MCMarcusAntony/MSXPi2/hardware/Schematic/MSXPi2 - Proto1/MSXPI2.kicad_pcb

## KiCad design hardware/Schematic/MSXPi2 - Proto1/MSXPI2.kicad_pcb (2020-07-24)

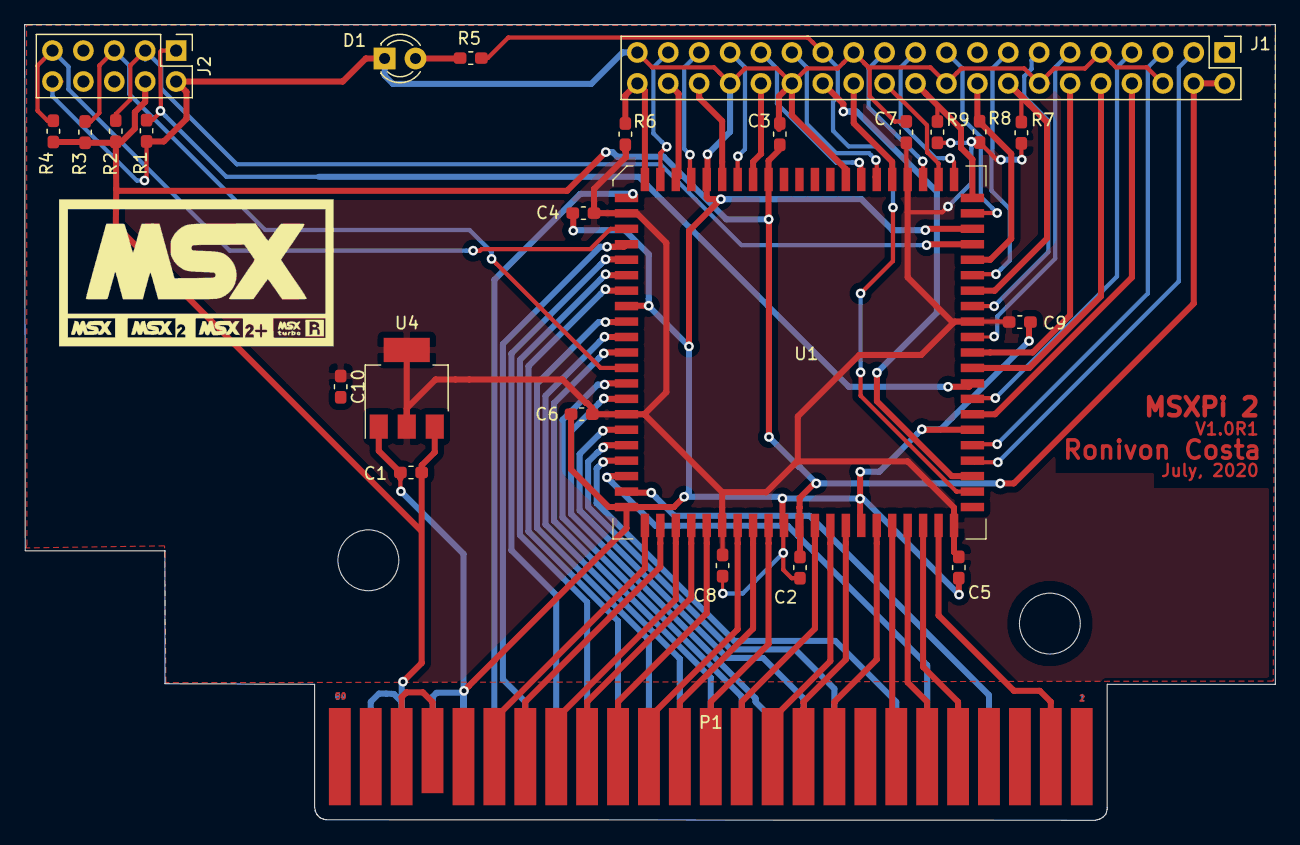
[picture p1: board MSXPI2.kicad_pcb from above]

Board: 2 copper layers, 102.8 x 65.4 mm, 25 parts (0 on the bottom side), 68 nets.

Parts:
C1, C2, C3, C4, C5, C6, C7, C8, C9, C10: C1; C_0603_1608Metric_Pad1.05x0.95mm_HandSolder
D1: LED; LED_D3.0mm
J1: Raspberry_Pi_2_3; PinHeader_2x20_P2.54mm_Vertical
J2: JTAG; PinHeader_2x05_P2.54mm_Vertical
P1: MSX_CONNECTOR; card_edge_connector
R1, R2, R3, R4, R5, R6, R7, R8, R9: R_US; R_0603_1608Metric_Pad1.05x0.95mm_HandSolder
U1: EPM7128SLC84-15; PLCC-84
U4: LD1117S33TR_SOT223; SOT-223-3_TabPin2

Connections:
+3V3: C4.2, C5.2, C6.2, C7.2, C8.2, C9.2, C10.1, R6.1, R7.1, R8.1, R9.1, U1.13, U1.26, U1.38, U1.53, U1.66, U1.78, U4.2
+5V: C1.1, C2.2, C3.2, J1.2, J1.4, J2.4, P1.45, P1.47, R2.2, R3.2, R4.2, U1.3, U1.43, U4.3
/A0: P1.28, U1.40
/A1: P1.27, U1.21
/A2: P1.30, U1.39
/A3: P1.29, U1.20
/A4: P1.32, U1.37
/A5: P1.31, U1.18
/A6: P1.22, U1.45
/A7: P1.21, U1.25
/A8: P1.24, U1.44
/A9: P1.17, U1.28
/A10: P1.20, U1.46
/A11: P1.19, U1.27
/A12: P1.23, U1.24
/A13: P1.26, U1.41
/A14: P1.25, U1.22
/A15: P1.18, U1.48
/BDIR: P1.10, U1.51
/D0: P1.34, U1.36
/D1: P1.33, U1.17
/D2: P1.36, U1.35
/D3: P1.35, U1.16
/D4: P1.38, U1.34
/D5: P1.37, U1.15
/D6: P1.40, U1.33
/D7: P1.39, U1.12
/IORQ: P1.11, U1.30
/MREQ: P1.12, U1.50
/RD: P1.14, U1.49
/SLTSL: P1.4, U1.52
/WAIT: P1.7, U1.31
/WR: P1.13, U1.29
GNDREF: C1.2, C2.1, C3.1, C4.1, C5.1, C6.1, C7.1, C8.1, C9.1, C10.2, D1.1, J1.6, J1.9, J1.14, J1.20, J1.25, J1.30, J1.34, J1.39, J2.2, J2.10, P1.41, P1.43, R1.1, U1.7, U1.19, U1.32, U1.42, U1.47, U1.59, U1.72, U1.82, U4.1
GPIO0: J1.27, R5.2, U1.55
GPIO1: J1.28, U1.56
GPIO02: J1.3, U1.57
GPIO03: J1.5, U1.58
GPIO04: J1.7, U1.61
GPIO05: J1.29, U1.80
GPIO06: J1.31, U1.81
GPIO07: J1.26, U1.79
GPIO08: J1.24, U1.76
GPIO09: J1.21, U1.75
GPIO10: J1.19, U1.73
GPIO11: J1.23, U1.77
GPIO12: J1.32, U1.4
GPIO13: J1.33, U1.5
GPIO14: J1.8, U1.60
GPIO15: J1.10, U1.63
GPIO16: J1.36, U1.6
GPIO17: J1.11, U1.65
GPIO18: J1.12, U1.64
GPIO19: J1.35, U1.8
GPIO20: J1.38, U1.9
GPIO21: J1.40, R6.2, U1.11
GPIO22: J1.15, U1.69
GPIO23: J1.16, R7.2, U1.68
GPIO24: J1.18, R8.2, U1.70
GPIO25: J1.22, R9.2, U1.74
GPIO26: J1.37, U1.10
GPIO27: J1.13, U1.67
unnamed: D1.2, R5.1
unnamed: P1.44, P1.46
TCK: J2.1, R1.2, U1.62
TDI: J2.9, R4.1, U1.14
TDO: J2.3, R2.1, U1.71
TMS: J2.5, R3.1, U1.23
