MCMarcusAntony/MSXPi2/hardware/CPLD Project/MSXPi2_Interface_Test_description.txt

Created on:Friday, July 03, 2020
Based on:MSXPi2
