MCMarcusAntony/MSXPi2/software/server/msxpi-server.py

import RPi.GPIO as GPIO
import mmap
import os
import time

version = "0.1"
build   = "20200704.00000"

# Pin Definitons
d0 = 26
d1 = 27
d2 = 2
d3 = 3
d4 = 4
d5 = 5
d6 = 6
d7 = 7

a0 = 8
a1 = 9
a2 = 10
a3 = 11
a4 = 12
a5 = 13
a6 = 14
a7 = 15
a8 = 16
a9 = 17
a10 = 18
a11 = 19
a12 = 20
a13 = 22

cs = 21
wr = 23
io = 24
rdy = 25
rpi_on = 30 # GPIO0 / ID_SD : These two pins are reserved, but may be posible
res2 = 31 # GPIO1 / ID?SC : to use them for output only - to be tested.

def init_gpio():
# Pin Setup:
    GPIO.setmode(GPIO.BCM)
    GPIO.setup(cs, GPIO.IN, pull_up_down=GPIO.PUD_DOWN)
    GPIO.setup(rdy, GPIO.OUT)
    GPIO.setup(wr, GPIO.IN)
    GPIO.setup(io, GPIO.IN)
    GPIO.setup(rpi_on, GPIO.OUT)
    GPIO.setup(res2, GPIO.OUT)
    GPIO.setup(d0, GPIO.IN)
    GPIO.setup(d1, GPIO.IN)
    GPIO.setup(d2, GPIO.IN)
    GPIO.setup(d3, GPIO.IN)
    GPIO.setup(d4, GPIO.IN)
    GPIO.setup(d5, GPIO.IN)
    GPIO.setup(d6, GPIO.IN)
    GPIO.setup(d7, GPIO.IN)
    GPIO.setup(a0, GPIO.IN)
    GPIO.setup(a1, GPIO.IN)
    GPIO.setup(a2, GPIO.IN)
    GPIO.setup(a3, GPIO.IN)
    GPIO.setup(a4, GPIO.IN)
    GPIO.setup(a5, GPIO.IN)
    GPIO.setup(a6, GPIO.IN)
    GPIO.setup(a7, GPIO.IN)
    GPIO.setup(a8, GPIO.IN)
    GPIO.setup(a9, GPIO.IN)
    GPIO.setup(a10, GPIO.IN)
    GPIO.setup(a11, GPIO.IN)
    GPIO.setup(a12, GPIO.IN)
    GPIO.setup(a13, GPIO.IN)

def rom_sim(arg=0):
    addr = 0
    data = 0
    # read A bus
    for bit in [a13,a12,a11,a10,a9,a8,a7,a6,a5,a4,a3,a2,a1,a0]:
        addr = addr << 1
        addr = addr | GPIO.input(bit)

    wr_n = not GPIO.input(wr)
    mreq_n = bool(GPIO.input(io))
    rd_n = not wr_n;
    iorq_n = not mreq_n;

    # read D bus
    if wr_n:
        for bit in [d7,d6,d5,d4,d3,d2,d1,d0]:
            data = data << 1
            data = data | GPIO.input(bit)

    print("Inputs")
    print("Address:",hex(addr))
    print("data:",hex(data))
    print("wr_n:",wr_n)
    print("mreq_n:",mreq_n)
    print("rd_n:", rd_n)
    print("iorq_n:",iorq_n)


    # Switch D bus to OUTPUT mode
    GPIO.setup(d0, GPIO.OUT)
    GPIO.setup(d1, GPIO.OUT)
    GPIO.setup(d2, GPIO.OUT)
    GPIO.setup(d3, GPIO.OUT)
    GPIO.setup(d4, GPIO.OUT)
    GPIO.setup(d5, GPIO.OUT)
    GPIO.setup(d6, GPIO.OUT)
    GPIO.setup(d7, GPIO.OUT)
    
    # Get the byte from the ROM file
    if rd_n:
        byte = ord(rombuffer[addr])
        print(hex(addr),hex(byte))
        GPIO.output(d0,byte & 0x1)
        GPIO.output(d1,byte & 0x2)
        GPIO.output(d2,byte & 0x4)
        GPIO.output(d3,byte & 0x8)
        GPIO.output(d4,byte & 0x10)
        GPIO.output(d5,byte & 0x20)
        GPIO.output(d6,byte & 0x40)
        GPIO.output(d7,byte & 0x80)

    # Pulse RPI_READY signal for CPLD know that RPI finished procesing
    GPIO.output(rdy, GPIO.LOW)
    GPIO.output(rdy, GPIO.HIGH)
    GPIO.output(rdy, GPIO.LOW)

    # Switch D bus to INPUT mode
    GPIO.setup(d0, GPIO.IN)
    GPIO.setup(d1, GPIO.IN)
    GPIO.setup(d2, GPIO.IN)
    GPIO.setup(d3, GPIO.IN)
    GPIO.setup(d4, GPIO.IN)
    GPIO.setup(d5, GPIO.IN)
    GPIO.setup(d6, GPIO.IN)
    GPIO.setup(d7, GPIO.IN)
   
 
def rom_buffer(filename, access=mmap.ACCESS_WRITE):
    print "rom_buffer:Starting"
    size = os.path.getsize(filename)
    if (size>0):
        fd = os.open(filename, os.O_RDWR)
        rc = mmap.mmap(fd, size, access=access)
    else:
        rc = RC_FAILED
    return rc

# ========================================================
# main program starts here
# ========================================================
init_gpio()
#GPIO.output(rdy, GPIO.LOW)
#GPIO.output(rdy, GPIO.HIGH)
#GPIO.output(rdy, GPIO.LOW)

GPIO.add_event_detect(cs, GPIO.RISING, callback=rom_sim)
GPIO.output(rpi_on, GPIO.LOW)
print "GPIO Initialized\n"
print "Starting MSXPi2 Server Version ",version,"Build",build

rombuffer = rom_buffer("/home/pi/msxpi2/frogger.rom")

print "st_recvcmd: waiting command"
try:
    while 1:
        pass

except KeyboardInterrupt: # If CTRL+C is pressed, exit cleanly:
   print("Keyboard interrupt")
   GPIO.output(rpi_on, GPIO.HIGH)
   GPIO.cleanup() 
