MCMarcusAntony/MSXPi2/hardware/CPLD Project/MSXPi2.vhd

-- Copyright (C) 1991-2013 Altera Corporation
-- Your use of Altera Corporation's design tools, logic functions 
-- and other software and tools, and its AMPP partner logic 
-- functions, and any output files from any of the foregoing 
-- (including device programming or simulation files), and any 
-- associated documentation or information are expressly subject 
-- to the terms and conditions of the Altera Program License 
-- Subscription Agreement, Altera MegaCore Function License 
-- Agreement, or other applicable license agreement, including, 
-- without limitation, that your use is for the sole purpose of 
-- programming logic devices manufactured by Altera and sold by 
-- Altera or its authorized distributors.  Please refer to the 
-- applicable agreement for further details.

library ieee;
use ieee.std_logic_1164.all;
library altera;
use altera.altera_syn_attributes.all;

entity MSXPi2 is
	port
	(

	   -- CPLD programming pins
		--TCK : in std_logic;
		--TDI : in std_logic;
		--TDO : out std_logic;
		--TMS : in std_logic;

		-- MSX Bus signals
		A : in std_logic_vector(15 downto 0);
		D : inout std_logic_vector(7 downto 0);
		RD_n : in std_logic;
		WR_n : in std_logic;
		MREQ_n : in std_logic;
		IORQ_n : in std_logic;
		BDIR : out std_logic;
		M1 : in std_logic;
		SLTSL : in std_logic;
		WAIT_n : out std_logic;
		
		-- Raspberry Pi GPIO
		rpi_d : inout std_logic_vector(7 downto 0);
		rpi_a : out std_logic_vector(13 downto 0);
		--GPIO_D[0] : inout std_logic; -- D0 / GPIO_26 / BCM26
		--GPIO_D[1] : inout std_logic; -- D1 / GPIO_27 / BCM27
		--GPIO_D[2] : inout std_logic; -- D2 / GPIO_2 / BCM2
		--GPIO_D[3] : inout std_logic; -- D3 / GPIO_3 / BCM3
		--GPIO_D[4] : inout std_logic; -- D4 / GPIO_4 / BCM4
		--GPIO_D[5] : inout std_logic; -- D5 / GPIO_5 / BCM5
		--GPIO_D[6] : inout std_logic; -- D6 / GPIO_6 / BCM6
		--GPIO_D[7] : inout std_logic; -- D7 / GPIO_7 / BCM7
		--GPIO_A[0] : out std_logic; -- A0 / GPIO_8 / BCM8
		--GPIO_A[1] : out std_logic; -- A1 / GPIO_9 / BCM9
		--GPIO_A[2] : out std_logic; -- A2 / GPIO_10 / BCM10
		--GPIO_A[3] : out std_logic; -- A3 / GPIO_11 / BCM11
		--GPIO_A[4] : out std_logic; -- A4 / GPIO_12 / BCM12
		--GPIO_A[5] : out std_logic; -- A5 / GPIO_13 / BCM13
		--GPIO_A[6] : out std_logic; -- A6 / GPIO_14 / BCM14
		--GPIO_A[7] : out std_logic; -- A7 / GPIO_15 / BCM15
		--GPIO_A[8] : out std_logic; -- A8 / GPIO_16 / BCM16
		--GPIO_A[9] : out std_logic; -- A9 / GPIO_17 / BCM17
		--GPIO_A[10] : out std_logic; -- A10 / GPIO_18 / BCM18
		--GPIO_A[11] : out std_logic; -- A11 / GPIO_19 / BCM19
		--GPIO_A[12] : out std_logic; -- A12 / GPIO_20 / BCM20
		--GPIO_A[13] : out std_logic; -- A13 / GPIO_22 / BCM22
		
		rpi_cs : out std_logic; -- RPI CS signal - send interrupt to RPi - GPIO_21 / BCM21
		rpi_wr : out std_logic; -- MSX access type: 1 = read, 0 = write - GPIO_23 / BCM23
		rpi_io : out std_logic; -- MSX IO type: 1 = port access, 0 = memory access - GPIO_24 / BCM24
		rpi_rdy: in std_logic; -- RPI_ready - GPIO_25 / BCM25
		rpi_on : in std_logic; -- BCM0
		GPIO_1 : in std_logic  -- BCM1
		
	);

end MSXPi2;

architecture ppl_type of MSXPi2 is

	signal msxpi_select: std_logic := '0';
   signal wait_n_s: std_logic := '1';
	signal a_s : std_logic_vector(15 downto 0);
   signal d_s: std_logic_vector(7 downto 0);
	signal rpi_d_s: std_logic_vector(7 downto 0);
	signal cs_s: std_logic := '0';
	signal wr_s: std_logic;
	signal io_s: std_logic;
	signal rpi_on_s: std_logic := '1';
	signal rpi_rdy_s: std_logic;
	signal msxpi_read_rom: std_logic;
	signal msxpi_read_mem: std_logic;
	signal msxpi_write_mem: std_logic;
	signal msxpi_read_io: std_logic;
	signal msxpi_write_io: std_logic;
	signal reset: std_logic := '0';
	
begin

	rpi_on_s <= not rpi_on;
	BDIR <= 'Z';   		
	WAIT_n <= wait_n_s;
	D <= rpi_d_s when msxpi_select = '1' or rpi_rdy = '1' else "ZZZZZZZZ";
	rpi_cs <= cs_s; --'1' when rpi_d_s = x"42" else cs_s;
	rpi_a <= a_s(13 downto 0);
	--rpi_d <= d_s;
	rpi_wr <= wr_s;
	rpi_io <= io_s;
	
	msxpi_read_rom <= '1' when sltsl = '0' and RD_n = '0' else '0';
	msxpi_read_mem <= '1' when (MREQ_n = '0' and RD_n = '0') else '0';
	msxpi_write_mem <= '1' when (MREQ_n = '0' and WR_n = '0') else '0';
	msxpi_read_io <= '1' when (IORQ_n = '0' and RD_n ='0') else '0';
	msxpi_write_io <= '1' when (IORQ_n = '0' and WR_n ='0') else '0';
	
	msxpi_select <= '1' when msxpi_read_rom = '1' and (A >= x"4000" and A < x"D000") else '0';
	                     --when msxpi_read_io = '1' and A(7 downto 0) = x"56" else '0';   
	                     --(msxpi_write_mem = '1' and (A = x"8000" OR A = x"9000" or A = x"BFFF")) or 	
							   --msxpi_read_rom = '1' else
						 
	process(msxpi_select,rpi_rdy, reset)
	begin
		if (rpi_rdy = '1' or reset = '1') then
			wait_n_s <= 'Z';
			cs_s <= '0';
			rpi_d_s <= rpi_d;
		elsif (msxpi_select'event and msxpi_select = '1') then
			wait_n_s <= '0';
			cs_s <= '1';
			a_s <= A;
			d_s <= D;
			wr_s <= WR_n;
			io_s <= IORQ_n;
		end if;
	end process;
			
	process(rpi_on_s)
	begin
	    if (rpi_on_s = '1') then
		     reset <= '0';
		 else
		     reset <= '1';
		 end if;
	end process;
end;



   
	
