MCMarcusAntony/MSXPi2/(commit log)

2020-07-04 fix to syntar errors
    [MSXPi2.vhd]
2020-07-05 RPi detects writes to 0x8000, but show wrong bus data
    [MSXPi2.vhd, MSXPi2_ROM.vhd]
2020-07-07 fix to control signals in msxpi-server
    [msxpi-server.py]
2020-07-24 updated with schematic rev 1
    [MSXPI2-B_Cu.gbl, MSXPI2-B_Mask.gbs, MSXPI2-B_Paste.gbp, MSXPI2-B_SilkS.gbo, MSXPI2-Edge_Cuts.gm1, MSXPI2-F_Cu.gtl, MSXPI2-F_Mask.gts, MSXPI2-F_Paste.gtp]
